greatscottgadgets/yardstick/docs/source/index.rst

==========================================
Welcome to YARD Stick One's documentation!
==========================================

.. toctree::
   :maxdepth: 2
   :caption: User Documentation

   yardstickone
   faq
   yardstickone_project_mentions
   
.. toctree::
   :maxdepth: 2
   :caption: Firmware

   firmware

.. toctree::
   :maxdepth: 2
   :caption: Hardware

   enclosureOptions
