greatscottgadgets/yardstick/docs/source/enclosureOptions.rst

=================
Enclosure Options
=================

YARD Stick One ships without an enclosure.  It is designed to fit 3A-260906U from New Age Enclosures, but you will need to drill a hole for the SMA connector.  Another good option to protect YARD Stick One is 5/8" clear heat shrink tubing.
