greatscottgadgets/yardstick/(threads)

Thread 1 (2016-11-08):

[question] regarding flashing

spaivaras, 2016-11-08:
First of all thank you for your awesome projects.
Currently i am building yardstick one by hand, manufactured pcb hand soldered components. The question is how about flashing the bare CC1111.

I only see mansions to GoodFET as a programer, but can I just use any jtag interface for it? Or does GoodFET uses some custom logic while flashing CC1111?

I understand that once I will have boot loader I will be able to install rfcat directly thru usb. But I am a bit lost on initial boot loader upload to CC1111 without GoodFET :)

Thank you

dominicgs, 2016-11-08:
The tricky part here is that the CC1111 speak a protocol that is similar to JTAG, but not JTAG.  The two adapters that I know support the protocol are the GoodFET and the TI CC Debugger.

spaivaras, 2016-11-08:
Damn, did some more research, and you are 100% right. I guess next product I will be making is GoodFET itself :D, In any case just ordered a knock off SmartRF04EB it seems they are something that can do "CC debugger" stuff as well. Thank you for the info, I guess this can be closed now.

Closed 2016-11-08.

Thread 2 (2018-09-28):

LED 1 inactive, and errors

nebula-cpp, 2018-09-28:
LED 1 is not active. This YardStick One I bought quit on me after a week. $130, and I'm peeved.

Output, no matter what I try:
Error in resetup():Exception('No Dongle Found. Please insert a RFCAT dongle.',)

I cannot solve this issue. There is nothing on the web describing my problem. I can't enter bootloader mode. This issue is prevalent no matter what computer I try it on. LED 2 and 3 light up, but not one. This doesn't make any sense, as LED 1 means "initialized" and 2 and 3 are regarding TX and RX being active. Can someone PLEASE help me?! I don't know where else to turn!

dominicgs, 2018-09-28:
Are you on a Linux system?  If so, what happens in `dmesg` when you plug in the YardStick One?

Does it show up in `lsusb` as an OpenMoko device?

nebula-cpp, 2018-09-28:
dmesg is no different with, or without the yardstick plugged in, and
neither is lsusb. There is no recognition that the yardstick is even
plugged in.

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

dominicgs, 2018-09-28:
Is that the same when you jumper the pins to get it in to bootloader mode?

nebula-cpp, 2018-09-28:
"The pins" isn't very specific, but, yes. I have tried every combination of
pins and looked at a couple diagrams to tell me which ones were 7 and 9
(there is one on a random forum on the internet, but i got lucky finding
that), and nothing changes. My computer, no matter what, does not recognize
the yardstick. None of my linux computer's do. Would you mind helping me
figure out which pins are 9 and 7? Or if those are even the correct pins to
connect? Maybe i did it wrong the whole time.

On Thu, Sep 27, 2018, 8:41 PM Dominic Spill <notifications@github.com>
wrote:

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

dominicgs, 2018-09-28:
Pins 7 & 9 are the two highlighted in red in this image:
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

I didn't realise we didn't have an image of this on the wiki, I'll add one.

nebula-cpp, 2018-09-28:
Just tried it, and... nothing :(

dominicgs, 2018-09-28:
Sounds like a defective YardStick One.  Possibly a bad solder joint on the CC1111.

I recommend contacting the reseller that sold you the device and asking for a replacement.

nebula-cpp, 2018-09-28:
Could you guide me through that? Bought it from Nooelec (think that's how
you spell it?). I bought it months ago as well. Am I just screwed?

dominicgs, 2018-09-28:
Use their customer support [form](https://support.nooelec.com/hc/en-us/requests/new) and refer them to this thread.

nebula-cpp, 2018-09-28:
Alright, thanks! Hopefully I don't to buy a new one. If I do, I'm buying
directly from great scott gadgets! Thank you so much! Have a great night,
day, morning, afternoon, or whatever it is where you are on earth :D

mossmann, 2019-03-19:
It looks like this was resolved by hardware replacement. Closing.

jfdhuiz, 2019-05-01:
Just to be clear, if I connect the YS1, I connect pins 7 and 9, and all 3 lights should flash? And if nothing flashes my YS1 is broken?

Closed 2019-03-19.

Thread 4 (2019-04-28):

3.3V and GND short circuit

zhaohuansi, 2019-04-28:
I went to the factory to produce PCBs and made SMT patches. The schematic and PCB drawings were downloaded from GITHUB. Unable to flash the firmware, after testing, found that 3.3V and GND are shorted. There is no short circuit in the empty pcb board. Does anyone have this problem?

Closed 2019-04-30.

Thread 5 (2019-12-21):

Yardstick one not getting detected, leds orange and red are dim stable when plugged in to any os

pjtchand, 2019-12-21:
I had started updating the firmware of the yardstick one, but unexpectedly the update got failed with some error after that, I'm not able to detect the yardstick one in my different operating systems. If I plug it in, it will be stable with dim LEDs red and orange.
please help me out of this and define a proper way for updating the firmware.

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

ChildishTurbino, 2020-03-06:
So did you fix the issue?

pjtchand, 2020-03-06:
Yes, I had fixed the issue, sorry for the inconvenience.

Thanks and regards,
GOPICHAND D

On Fri, Mar 6, 2020 at 5:45 AM ChildishTurbino <notifications@github.com>
wrote:

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

ChildishTurbino, 2020-03-06:
May i ask how you fixed your issue? The LED's Come up the same on my YS1

pjtchand, 2020-03-06:
I just used the jumper cable and shorted the mentioned ports as mentioned
in one of the websites.

On Fri, Mar 6, 2020 at 6:45 AM ChildishTurbino <notifications@github.com>
wrote:

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

ChildishTurbino, 2020-03-06:
I'm guessing 7 and 9 to go into bootloader mode, but what did you do after that, i cant seem to get it to work.

ChildishTurbino, 2020-03-06:
Any Guidance?

pjtchand, 2020-03-06:
Yup I did the same, connected 7 & 9 pins to start bootloader and then ran the update script. I had successfully updated my Ys1 to latest firmware.

Best Regards,
GOPICHAND D

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

ChildishTurbino, 2020-03-06:
May i ask Which Update Script if you remember, because i have gone through the steps more than 20 times and it still does not seem to work

Closed 2019-12-21.

Thread 6 (2020-03-05):

Does not connect To Computer

ChildishTurbino, 2020-03-05:
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
Only LED 2 and 3 On Out the Factory, The Yard stick One does not come up when I type “lsusb”. When I jump pin 7 and 9 to get to the boot loader it pops up but I can’t seem to flash it beaus it just dosent connect properly. It could be DOA

GravesJake, 2020-04-02:
Sorry for the late response to this. Are you still having issues in the bootloader mode?

ChildishTurbino, 2020-04-02:
Yes I was, I did return the YARD Stick One in for a HackRF One though, Thank you, Appreciate It!

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

Closed 2021-01-23.

Thread 8 (2020-08-22):

USB Device malfunction

akuuka1, 2020-08-22:
helllo world!
 USB device connected has malfunctioned windows does not recognize"
_is the prompt upon connection of out-of-the-box ... as a novice, what can i do to rectify/ Ty

mossmann, 2021-01-24:
It is possible to use YARD Stick One on Windows if you first install [Zadig](https://zadig.akeo.ie/). We do our development on Linux, so the most reliable way to get YARD Stick One up and running is to do so on Linux.

akuuka1, 2021-01-24:
Hey thank u so much for the reply- I got er sorted out, man I also
purchased the hack1rf- u guys make out standing products- can I ask you,
how or what can I do to increase the reception? Also , have u tried the
HackRf_test app for android? Its pretty cool- keep those Alist products
rolling!!!

Joshua ketola aka

AKUUKA

On Sat., Jan. 23, 2021, 5:13 p.m. Michael Ossmann, <notifications@github.com>
wrote:

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

mossmann, 2021-01-26:
Thanks for the kind words! I haven't tried the HackRF_Test app, but it looks like it comes from @demantz who does great work! I have used his RFAnalyzer.

If you need to increase receive sensitivity of your HackRF, try adjusting all three gain settings. The `hackrf_transfer -h` help output gives details about the range of those settings. Also selecting an appropriate antenna for your application can make a big difference. If those things aren't enough and you need a further boost for a weak signal, you can try an external LNA between the HackRF and antenna.

akuuka1, 2021-01-26:
Hey thank you so much for your help,  im a little confused- I can adjust
the gains ? Is the a specific interface  You are referring to? I didn't
notice anything on the module Clearly I have  Some reading to do... Also
yes the office fantastic and I also use RFanalyzer,  Though I am very new
to the field and it's quite slow going I have a smalle module that I
purchased until 20 decimal increase amplifier  I will send you a picture it
looks pretty good.  Once again thank you your products or just kick ass if
you have any insight for me regarding the game in parameter changing  I
would love to know

Take care and hope to hear from you

On Mon., Jan. 25, 2021, 5:34 p.m. Michael Ossmann, <notifications@github.com>
wrote:

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

mossmann, 2021-03-02:
Sorry I overlooked your reply. The gain settings I was referring to (from `hackrf_transfer -h`) are:
```
	[-a amp_enable] # RX/TX RF amplifier 1=Enable, 0=Disable.
...
	[-l gain_db] # RX LNA (IF) gain, 0-40dB, 8dB steps
	[-g gain_db] # RX VGA (baseband) gain, 0-62dB, 2dB steps
```
They may be called different things depending on the software you use. There is some more information about them in the FAQ:
https://github.com/mossmann/hackrf/wiki/FAQ#making-sense-of-gain-settings

If you need further help with your HackRF One, please open an issue on the HackRF repo:
https://github.com/mossmann/hackrf/

akuuka1, 2021-03-02:
Wow thank you , I really appreciate the reply- its such a broad field of
learning, doin my best tho

Cheers!

On Mon., Mar. 1, 2021, 7:22 p.m. Michael Ossmann, <notifications@github.com>
wrote:

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

Dougsworth, 2021-03-18:
Hi. I just got a yardstick one. I understand that its used with linux. Ive loaded up vmware on my laptop ith kalilinux but for some reason i get the usb is malfunctioned message when i plug it into my laptop. Any help please?

Dougsworth, 2021-03-18:
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

zadig detects the yardstick one as a vmware usb device it seems. but i dont see it displayed in kali-linux with lsusb

Closed 2021-01-24.

Thread 9 (2021-07-22):

Device might be DOA?

n0xa, 2021-07-22:
My wife bought a YARD Stick One for me for Christmas, and things have been busy. I don't use Linux much at home, and it looked like getting it working under Windows or Mac was going to be problematic, so it's been shelved for a good 7-8 months.

I finally installed Kali on an older laptop, got RFCat installed, but it tells me there's no dongle attached. Upon checking dmesg, I see:

"new full-speed USB device number -n- using ehci-pci" followed by "device not accepting address -n-, error -32" and finally "unable to enumerate USB device" with an occasional "attempt power cycle" message in between them. This happens regardless the USB port I try to use.

On my main desktop (running OpenBSD 6.9), the only thing that shows up in dmesg is "uhub5: device problem, disabling port -n-" and typical behavior for a device that's not supported by the kernel (such as the HackRF One) is 'ugen0 at uhub5 port 1 "Great Scott Gadgets HackRF One" ...' so it's unusual to have no device show up at all, just getting a port error.

The 3-pin IC nearest LED2 on my YARD Stick One (a voltage regulator, maybe?) gets untouchably hot after about 30 seconds of being plugged in. Examining the product under a magnifier, it seems to be properly constructed, with no solder bridges or obvious component damage (scorch marks, cracked IC packages, etc). This is the first time I have tried to use it at all. I hadn't plugged it in to any computer before yesterday.

I did jumper pins 7 and 9 on P1 to see if enabling bootloader mode makes any difference. It does not change the behavior on my Kali Linux laptop.

Ideas?

meeas, 2021-08-18:
So, I assume you are running into a few issues all at once.

First off, Kali's rfcat package has been broken over the last two years, and I suspect still is.  They tried to modify the code to make it Python3 compatible and didn't fully test their changes.  I'm not sure if that is still the case or not, but I'd recommend removing the Kali package and installing it with `pip install rfcat`.  You can also try out my VM over at https://www.controlthings.io/platform which has a functional version of rfcat installed with all the required dependencies (which I think pip is missing one...)

Second, the default firmware that ships with the Yardstick is not recognized by Windows 10, so any attempts to use a Linux VM on top of Windows 10 will fail until you re-flash the Yardstick to a later version, which can only be done on Linux installed on bare metal.  I helped @tlas update the rfcat readme so flashing should be a little more clear that it was in the past.

It really is a great tool once you get it working, its just a little bit of a climb first.

I'd also recommend joining the GSG Discord server for further support.  I think that is monitored better, and I know for myself, that I'd probably see your response faster there.  You can do that here:

https://t.co/MjDOrCSaf5?amp=1

straithe, 2021-08-22:
Just to clarify, GSG does encourage issues to be posted on GitHub and not in the Discord as the Discord is not monitored by any of the staff. Of course we do have wonderful community members, such as @meeas who are available to help. Saying that, we at GSG are a bit behind of GitHub issues right now and for that I apologize.

n0xa, 2021-08-22:
I have installed rfcat via pip on my Pi4 Kali (which never had rfcat installed via the repositories) and when I plug in the YardStick One, I still see no sign of the kernel detecting it via lsusb or dmesg, and rfcat predictably says No dongle found.

Attached are two photos of the board. One is up-close to the component (circled) which is heating up. It gets too hot to touch in a matter of seconds. I noticed this when I felt a burning sensation unplugging it for the first time when I started trying to work with the device shortly before reporting the issue. The other photo is the entire component side of the board. If you need higher resolution, I'll have to take pictures of it in segments.

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

straithe, 2021-08-23:
Can you send a picture of the back as well? Also, where did you want the device?

n0xa, 2021-08-23:
Reverse side of the board. My wife says she bought this and the HackRF One (which works great) from Hacker-Gadgets [.] com and when I asked her, she noted that it took several weeks to show up. I notice they do not seem to be on your "Where to buy" page at present time. This would have been purchased sometime in November 2020. Do I have a counterfeit??? The HRF1 works great.

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

straithe, 2021-08-23:
It looks like both the HackRF and the YARD Stick you received might be knockoffs (based on the website in question), but it is hard to tell with the YARD Stick, and that's fine! :) It just helps with debugging and providing suggestions to know what the board looks like and where it was purchased from.

In this case, the components do appear like they may have been hand soldered on, and the component that is heating up is the voltage regular, so I do feel you may have a short somewhere. In this case I typically recommend contacting the reseller to see if you can get an exchange. I'm not sure if the store your wife purchased from will provide that service though. If they won't do an exchange or return I suggest looking over the board thoroughly for a short and attempting to resolder the piece.

straithe, 2021-09-29:
I'm going to close this as there hasn't been a response in a while, but please re-open this issue or open a new one if you still need assistance.

Closed 2021-09-29.

Thread 11 (2021-08-16):

Compatible Enclosure

coojames1010, 2021-08-16:
The Yardstick One was designed to fit P3A-260906U from New Age Enclosures. Drilling a hole for the SMA connector is required.

Closed 2021-11-02.

Thread 16 (2021-11-12):

Documentation needs FAQ on Windows 10 "Invalid Configuration Descriptor" error.

martinling, 2021-11-12:
Symptom:

Yardstick One shows up in the Windows 10 Device Manager as an "Unknown USB Device", with the error "Invalid Configuration Descriptor".

Cause:

The error message is accurate; there is an off-by-one error in the configuration descriptor returned by older firmware - specifically any version before this rfcat commit https://github.com/atlas0fd00m/rfcat/commit/b2a10d8bbecfb9792806b4d18b5c66ad93bd3766.

Solution:

Update the firmware to the latest release.

Thread 20 (2022-02-02):

YARD Stick One Not Found

cw7664, 2022-02-02:
Hey there,

I cannot get my YS1 to work on Windows 11 or my Ubuntu 20.04 VM (VirtualBox). I have tried following all the documentation on here and the rfcat repository and every forum I could find.

Windows gives me some generic "Device not recognized/damaged" error message and just doesn't show up at all in Ubuntu. I got it to appear on Windows as a COM port when put it into bootloader mode by shorting pins 7 and 9 (all 3 LEDs did light up). However, I was still not able to do anything with it.

Back in Ubuntu I tried reloading firmware onto the device following [this](https://roaldnefs.com/posts/2019/01/update-yard-stick-one-firmware/) using both the methods described and had no luck. It kept giving me the "Dongle not found" error message when using "$ rfcat -r" or a message along the lines of "Device being used by something else like a manager." Sorry, I am not at my workbench to give you exact messages. But I have tried unplugging and replugging it dozens of times and nothing.

Next, I tried to downgrade my SDCC version from 3.8.0 to 3.5.0, but it could not be found in the repository.

Then tried installing the libusb-32 drivers using Zadig (along with the other drivers) with and without it in bootloader mode. No cigar.

I have scoured the internet and tried everything I could find on here and other forums with no success. I don't know if it is not compatible with my updated setup or what.

Thanks in advance.

mossmann, 2022-03-14:
Based on the fact that the device appeared in Windows in bootloader mode, I think it is very likely that this problem can be solved with a firmware update. I recommend trying to update the firmware using a native Linux installation. Updating the firmware in a Linux VM on top of a Windows host OS may not be possible given the current state of the installed firmware.

straithe, 2022-04-30:
I'm going to close this as there hasn't been a response in a while, but please re-open this issue or open a new one if you still need assistance.

Closed 2022-04-30.

Thread 22 (2022-05-04):

Schematics as PDF

wimton, 2022-05-04:
Can you please add a PDF version of the schematics and the PCB layout, so the interested can view them without having to download a whole CAD program?

straithe, 2022-05-04:
Thank you for the suggestion. I will get this done in June as I am about to go on vacation for a few weeks.

pickeditmate, 2022-05-11:
> To [pickeditmate](https://github.com/pickeditmate): the azalea.pdf seems to have little relation to the Yardstick One, but it is a good example of the format.

Sorry about that, was practicing with greatfet how to export. Ive no clue what layers you want for pcb pdf so I'll leave that to the pro's
[yardstickone sch.pdf](https://github.com/greatscottgadgets/yardstick/files/8671280/yardstickone.sch.pdf)

wimton, 2022-05-12:
Thanks, that is a very usable information on how the components are interconnected! I guess that the people interested in the PCB layers will use a CAD program anyway.

Closed 2022-05-12.

Thread 23 (2022-05-12):

Device not found after a Python exception

wimton, 2022-05-12:
When an exception is thrown in a Python program, the error: "Error in resetup():USBTimeoutError(110, 'Operation timed out') appears on a subsequent invocation and the YS1 must be unplugged and reinserted.
OS:  Recent Kali on 64-bit Intel. Using Python code, Git from 22-04-2022

pickeditmate, 2022-05-16:
That's very common, especially when forgetting to set setmodeIDLE() at the end of scripts.

straithe, 2022-07-20:
@wimton did @pickeditmate's suggestion help?

straithe, 2022-09-19:
I'm closing this as there hasn't been a response in over 30 days. Please re-open this issue or open a new one if you still need assistance.

Closed 2022-09-19.

Thread 24 (2022-09-19):

trouble configuring YS1 with Rfcat

slikkmulah, 2022-09-19:
So yea, Im pretty new to linux but I just had a buddy of mine help me install RFCAT and when the time came to plug in my ys1 and get them paired up, my windows 10 laptop said that the device is not recognized and is malfunctioning and the ys1 had 0 LED's lighting up. I tried many things to get it working finally after a while i put it bootloader mode and my laptop finally was recognizing the device as "yard stick one bootloader".

So i got back to trying to flash it and I just cannot get the Rfcat software to recognize the ys1. I try and flash the YS1 in bootloader mode with the correct command for flashing it (cant remember exactly what that command is) and all i get back is "no dongle found" message. So I thought YS1 was broken/faulty so i order a new one and I go to plug the new YS1 in for the very first time and yet again, no LED's and the message saying that its unrecognized and malfunctioning. I tried  this on my pc too and same problem.

PLZ HELP! Thx.

straithe, 2022-09-19:
Can you please post a screenshot of the error message you are getting?

slikkmulah, 2022-09-19:
Yes, here you go.

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

straithe, 2022-09-19:
You will have to visit the GitHub issue page and post a picture. Attaching the picture when replying by email does not work to add it to this thread.

slikkmulah, 2022-09-19:
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

slikkmulah, 2022-09-19:
Oh, sorry about that I haven’t  used the issue subsection before.

slikkmulah, 2022-09-20:
Hello, do you have time to help me with this issue today

straithe, 2022-12-05:
Is this in a VM, or baremetal?

slikkmulah, 2022-12-06:
I fixed this a long time ago. Thank you anyways though.

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

Closed 2022-12-06.
