greatscottgadgets/yardstick/(commit log)

2012-10-19 added tc14badge
    [tc14badge.brd, tc14badge.sch]
2012-10-19 KiCad note
2012-10-19 added tc14badge docs: schematic, assembly diagram, parts list
    [tc14badge-part-list.csv]
2012-11-11 started cc1111dongle from copy of tc14badge schematic
    [cc1111dongle.sch]
2012-11-12 finished cc1111dongle schematic
    [cc1111dongle.sch]
2012-11-12 replaced some obsolete part numbers
    [cc1111dongle.sch]
2012-11-12 extra decoupling based on BGA616 app note
    [cc1111dongle.sch]
2012-11-19 initial placement
    [cc1111dongle.brd, cc1111dongle.sch]
2012-12-10 finished layout first pass
    [cc1111dongle.brd, cc1111dongle.sch]
2012-12-11 RF switch decoupling caps
    [cc1111dongle.brd, cc1111dongle.sch]
2012-12-11 GND zone cutout under crystal
    [cc1111dongle.brd]
2012-12-11 better QFN heat sinking
    [cc1111dongle.brd]
2012-12-11 plot options
    [cc1111dongle.brd]
2012-12-17 updated PCB specifications to match oshpark.com 4 layer service
2013-02-09 11 jan 2013 update
    [cc1111dongle.brd, cc1111dongle.sch]
2013-02-09 renamed cc1111dongle directory to yardstickone
    [cc1111dongle.brd, cc1111dongle.sch]
2013-02-09 renamed cc1111dongle files to yardstickone
    [yardstickone.brd, yardstickone.sch]
2013-02-09 completed renaming to YARD Stick One
    [yardstickone.brd, yardstickone.sch]
2014-04-13 extended RF switch pads for easier soldering
    [yardstickone.brd]
2014-04-13 changed from BNC to SMA connector
    [yardstickone.brd, yardstickone.sch]
2014-04-13 silkscreen update
    [yardstickone.brd]
2014-04-13 changed RF traces from 13 to 12 mils for theoretically better impedance (OSH Park)
    [yardstickone.brd]
2014-04-13 reduced solder mask clearance and set paste clearance to 0 (OSH Stencils)
    [yardstickone.brd, yardstickone.sch]
2014-06-03 Add turnipschool (copied from tc14badge)
    [turnipschool.brd, turnipschool.sch]
2014-06-04 Add USB hub to TURNIPSCHOOL
    [turnipschool.sch]
2014-06-05 Remove trace antenna, swap connector for pad
    [turnipschool.sch]
2014-06-08 Add changes suggestted by mossmann
    [turnipschool.sch]
2014-06-09 Put crystal load capacitors back to sensible values (I shouldn't do late night maths)
    [turnipschool.sch]
2014-06-09 All parts are now 0402s where possible.
    [turnipschool.sch]
2014-06-25 fixed some ERC errors
    [turnipschool.sch]
2014-06-25 board outline
    [turnipschool.brd]
2014-06-25 initial component placement
    [turnipschool.brd]
2014-06-25 started tracks
    [turnipschool.brd]
2014-06-28 managed to route downstream USB without swapping ports
    [turnipschool.brd]
2014-06-28 50 mil header for downstream cable
    [turnipschool.brd, turnipschool.sch]
2014-06-28 more tracks
    [turnipschool.brd]
2014-06-28 fixed XTAL symbols
    [turnipschool.brd, turnipschool.sch]
2014-06-28 fixed USB2412 symbol, connected all tracks
    [turnipschool.brd, turnipschool.sch]
2014-06-28 moved P6
    [turnipschool.brd]
2014-06-28 silkscreen text
    [turnipschool.brd]
2014-06-28 DRC fixes
    [turnipschool.brd]
2014-06-28 minor schematic cleanup
    [turnipschool.brd, turnipschool.sch]
2014-06-28 silkscreen text tweak
    [turnipschool.brd]
2014-07-02 updated PCB specs
2014-12-14 magnetic sensor for bootloader activation
    [turnipschool.brd, turnipschool.kicad_pcb, turnipschool.sch]
2014-12-14 corrected hub supply connections, added required 1.5k USB pull-up, removed debug LED
    [turnipschool.kicad_pcb, turnipschool.sch]
2014-12-16 swapped downstream USB ports, made CC1111 port removable on the hub, improved layout
    [turnipschool.kicad_pcb, turnipschool.sch]
2014-12-16 improved supply zones
    [turnipschool.kicad_pcb]
2014-12-17 general layout cleanup
    [turnipschool.kicad_pcb]
2014-12-17 a little more cleanup
    [turnipschool.kicad_pcb]
2014-12-17 removed thermals under QFNs
    [turnipschool.kicad_pcb]
2014-12-17 updated date on silkscreen
    [turnipschool.kicad_pcb]
2014-12-18 moved magnetic sensor to DC pin
    [turnipschool.kicad_pcb, turnipschool.sch]
2014-12-19 reworked layout so USB traces have contiguous zones beneath them
    [turnipschool.kicad_pcb, turnipschool.sch]
2014-12-19 added programming pins to expansion header, made compatible with GoodFET pinout
    [yardstickone.brd, yardstickone.kicad_pcb, yardstickone.sch]
2014-12-19 moved balun closer to U1
    [yardstickone.kicad_pcb]
2014-12-19 replaced TX amp with SPF5043Z
    [yardstickone.kicad_pcb, yardstickone.sch]
2014-12-19 corrected TX amp orientation
    [yardstickone.kicad_pcb, yardstickone.sch]
2014-12-19 replaced RX amp with BGA420
    [yardstickone.kicad_pcb, yardstickone.sch]
2014-12-19 rotated RX amp
    [yardstickone.kicad_pcb, yardstickone.sch]
2014-12-19 updated PCB specs in README
2014-12-19 moved balun even closer
    [yardstickone.kicad_pcb]
2014-12-20 update date on silkscreen
    [yardstickone.kicad_pcb]
2015-01-06 bom update
    [turnipschool.sch]
2015-01-07 zone update
    [yardstickone.kicad_pcb]
2015-01-09 corrected USB connector BOM info
    [turnipschool.kicad_pcb, turnipschool.sch]
2015-01-27 nudged refs for assembly diagram
    [yardstickone.kicad_pcb]
2015-01-27 changed R6 from 10k to 100k for improved reliability of magnetic sensor bootloader activation
    [turnipschool.kicad_pcb, turnipschool.sch]
2015-01-27 changed R17 part selection to 0402
    [turnipschool.sch]
2015-01-27 moved R17 from DM to DP
    [turnipschool.kicad_pcb, turnipschool.sch]
2015-01-27 restored debug LED
    [turnipschool.kicad_pcb, turnipschool.sch]
2015-01-27 remembered to save schematic
    [turnipschool.kicad_pcb, turnipschool.sch]
2015-02-18 added 900 MHz low pass filter
    [yardstickone.sch]
2015-02-18 replace 0 ohm R7 with PCB trace
    [yardstickone.sch]
2015-02-18 added antenna port power control
    [yardstickone.sch]
2015-02-18 updated layout with recent schematic changes
    [yardstickone.kicad_pcb]
2015-02-18 layer legend
    [yardstickone.kicad_pcb]
2015-02-18 silkscreen box
    [yardstickone.kicad_pcb]
2015-02-18 moved silkscreen label away from via
    [yardstickone.kicad_pcb]
2015-02-18 saved schematic
    [yardstickone.kicad_pcb, yardstickone.sch]
2015-02-18 reversed MOSFET drain and source
    [yardstickone.kicad_pcb, yardstickone.sch]
2015-02-18 trace clean-up
    [yardstickone.kicad_pcb]
2015-02-19 added URL, moved a few traces
    [yardstickone.kicad_pcb]
2015-02-28 LED part selection
    [yardstickone.sch]
2015-07-06 changed R11 value to tone down red LED2
    [yardstickone.kicad_pcb, yardstickone.sch]
2015-07-06 renumbered confusing diode reference numbers
    [yardstickone.kicad_pcb, yardstickone.sch]
2015-07-23 set INSERT attributes
    [yardstickone.kicad_pcb]
2015-09-29 copied repo from https://github.com/mossmann/cc11xx and removed non-YARD Stick designs
    [tc14badge-part-list.csv, tc14badge.brd, tc14badge.sch, turnipschool.kicad_pcb, turnipschool.sch]
2015-09-29 replaced crystal load caps with 30 pF
    [yardstickone.kicad_pcb, yardstickone.sch]
2021-12-09 Update for "modern" KiCAD. (#19)
    * YS1 hardware: Update for "modern" KiCAD.
    * YS1 hardware: Replace DMC2400UV with SSM6L36FE,LM.
    * YS1 hardware: More KiCAD 5 cleanup
    Update LED symbol orientation
    Update LED footprint and footprint orientation
    Correct U3 & U8 Manufacturer
    * YS1 hardware: Remove yardstickone.net
    [yardstickone.kicad_pcb, yardstickone.sch]
2022-05-31 YS1 Hardware: Update repo for KiCAD 6
    [yardstickone.kicad_sch]
2022-08-02 Hardware: Add SKY13251 and associated lib symbol
    [yardstickone.kicad_sch]
2022-08-02 Hardware: Remove old SKY13385 switches.
    [yardstickone.kicad_sch]
2022-08-03 Hardware: Update schematic
    *Annotate new and changed symbols
    *Add footrpint for C31
    [yardstickone.kicad_sch]
2022-08-03 Hardware: Add new footprint for SKY13251.
    [yardstickone.kicad_sch]
2022-08-05 YS1 Hardware: Migrate all legacy footprints to modern format
    *Switch all legacy footprints to available library footprints that can be switched.
    *Create modern footprints for all other legacy footprints.
    [yardstickone.kicad_sch]
2022-08-05 YS1 Hardware: Populate PCB design with updated footprints from previous commit.
    [yardstickone.kicad_pcb]
2022-08-08 YS1 Hardware: Update PCB layout.
    *Place and route U5, U6, & C31
    *Correct placement & orientation of updated footprints
    *Clean up layout after r2 changes
    [yardstickone.kicad_pcb, yardstickone.kicad_sch]
2022-08-08 YS1 Hardware: Remove DRC markers
    [yardstickone.kicad_pcb]
2022-08-11 YS1 Hardware: Improve RF siganl routing in schematic.
    *Re-route RF signals between the two SKY13251 switches so that no RF traces will cross one another.
    *Correct the control signals to accurately reflect the RF signal routing.
    [yardstickone.kicad_pcb, yardstickone.kicad_sch]
2022-08-11 YS1 Hardware: Add decoupling caps.
    *Add decoupling caps for SKY13251 control signals
    [yardstickone.kicad_sch]
2022-08-11 YS1 Hardware: Update value of new decoupling caps.
    [yardstickone.kicad_sch]
2022-08-12 YS1 Hardware: Update schematic and begin PCB layout changes.
    [yardstickone.kicad_pcb, yardstickone.kicad_sch]
2022-08-16 YS1 Hardware: Finish routing for r2.
    *Layout and route decoupling caps for RF switch control signals
    *Route RF paths through switches
    *Fix P0_0 net routing
    [yardstickone.kicad_pcb, yardstickone.kicad_sch]
2022-08-17 YS1 Hardware: Clean up silkscreen for r2 changes.
    [yardstickone.kicad_pcb]
2022-08-17 YS1 Hardware: Clean up back silkscreen.
    [yardstickone.kicad_pcb]
2022-08-19 YS1 Hardware: Clean up PCB layout.
    *Add GND via to U7 pin 2
    *Move RF traces away from vias and other traces
    *Fix clearance violation on U3
    [yardstickone.kicad_pcb]
2022-08-22 YS1 Hardware: Replace obsolete crystal.
    Replace 2-pin 7A-48.000MAAJ-T 48 MHz crystal with 4-pin RH100-48.000-18-F-3030-TR crystal.
    [yardstickone.kicad_sch]
2022-08-24 YS1 Hardware: Re-route X1; Clean up trace widths
    *Shorten trace lengths to X1 crystal and reposition/re-route load caps
    *Make control signal traces the same trace width
    [yardstickone.kicad_pcb]
2022-08-25 YS1 Hardware: Add part numbers for U5 & U6
    [yardstickone.kicad_sch]
2022-09-26 YS1 Hardware: Clean up notes on schematic; Update metadata
    [yardstickone.kicad_pcb, yardstickone.kicad_sch]
2022-10-04 YS1 Hardware: Remove legacy kicad files.
2022-11-09 YS1 Hardware: Change C10/11 to 27pF
    [yardstickone.kicad_sch]
2022-11-10 YS1 Hardware: Update D4 part number.
    [yardstickone.kicad_sch]
2022-11-16 YS1 Hardware: Remove yardstickone.pro and yardstickone.sch
    [yardstickone.sch]
2022-11-16 YS1 Hardware: update the date on the PCB and in the tilte blocks.
    [yardstickone.kicad_pcb, yardstickone.kicad_sch]
2022-11-16 YS1 Hardware: Remove url from silkscreen.
    [yardstickone.kicad_pcb]
2022-11-16 YS1 Hardware: Add "TM" to YARD Stick One.
    [yardstickone.kicad_pcb]
2022-11-16 YS1 Hardware: Fix SKY13251 library symbol.
    *Put SKY13251 library symbol into cc1111.kicad_sym
    *Change pins 3, 6, & 7 from 'power input' to 'input'
    [yardstickone.kicad_sch]
2022-11-16 YS1 Hardware: Fix silkscreen for C4, C7, & R2
    [yardstickone.kicad_pcb]
2022-11-23 YS1 Hardware: Fix library symbols for U3 & U8.
    change pins 1, 3, 4, & 6 from "bidirectional" to "passive"
    [yardstickone.kicad_sch]
2022-11-23 Ys1 Hardware: Update minimum drill size and board edge clearance.
2022-11-23 YS1 Hardware: Move P2 to conform with board edge clearance requirements.
    [yardstickone.kicad_pcb]
2022-11-23 Ys1 Hardware: Update board setup to ignore silkscreen being clipped by soldermask.
2022-11-28 YS1 Hardware: Replace legacy jumpers with Net-Ties. Clean up unconnected wires.
    *Replace old jumper symbols/footprints for R7, R13, & R16 with a net-tie symbol/footprint.
    *Delete unconnected wires around the PCB layout.
    [yardstickone.kicad_pcb, yardstickone.kicad_sch]
2022-11-28 YS1 Hardware: Clean up ERC warnings/violations on PCB layout.
    *Move "DC" silkscreen
    *Nudge U5/C27
    *Reduce size of "P1" on silkscreen
    [yardstickone.kicad_pcb]
2023-04-25 YS1 Hardware: Add NT_0603_jumper.kicad_mod
    [yardstickone.kicad_pcb, yardstickone.kicad_sch]
2023-04-25 YS1 Hardware: Update revision number according to new semantic versioning guidelines
    [yardstickone.kicad_pcb, yardstickone.kicad_sch]
2023-06-12 restore mounting holes
    [yardstickone.kicad_pcb]
2023-06-12 update date
    [yardstickone.kicad_pcb]
2023-06-12 restore 0915LP15B026.kicad_mod
    [yardstickone.kicad_pcb, yardstickone.kicad_sch]
2023-06-12 update copyright and license
    [yardstickone.kicad_pcb, yardstickone.kicad_sch]
2023-06-12 update zones
    [yardstickone.kicad_pcb]
2023-06-12 add mounting hole attributes
    [yardstickone.kicad_pcb]
2023-06-12 restore pre-r2 footprints for J1 and P1
    to correct placement
    [yardstickone.kicad_pcb]
2023-06-12 remove J1 and P1 pads from silkscreen layer
    [yardstickone.kicad_pcb]
2023-06-12 remove non-plated-through holes from copper layers
    KiCad will now place these holes in the correct drill output file.
    [yardstickone.kicad_pcb]
2023-06-15 update fabrication attributes
    Prevent J1, P1, and P2 from appearing in SMD position files.
    [yardstickone.kicad_pcb]
2023-06-15 adjust position of LED silkscreen labels
    [yardstickone.kicad_pcb]
2023-06-15 correct name of CC1111 footprint
    [yardstickone.kicad_pcb, yardstickone.kicad_sch]
2023-06-16 correct Note field name
    [yardstickone.kicad_sch]
