greatscottgadgets/yardstick/(notices)

Notices in the files:
yardstickone/yardstickone.kicad_pcb:
Copyright 2012-2023 Great Scott Gadgets
Licensed under the CERN-OHL-P v2
